wesley-souza8/bruxo-citizentech/cad/totem_bruxo_makerlab-view.dxf

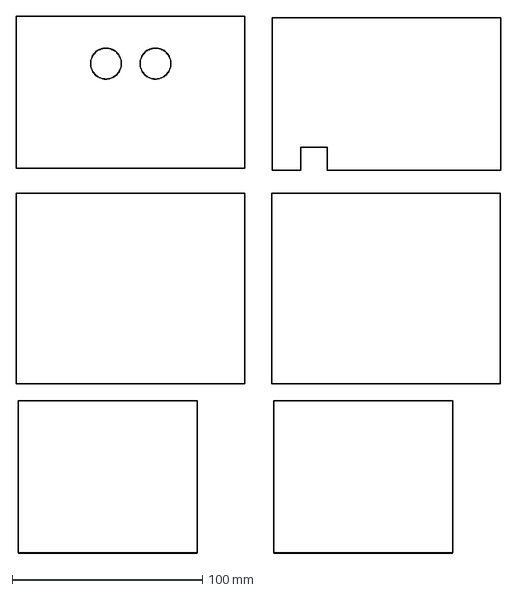
[picture p9: CAD file, 2026-11-10]
cad/totem_bruxo_makerlab-view.dxf
254.2 x 282.0 mm
