wesley-souza8/bruxo-citizentech/src/servicos.py

import os
import re
import time
import urllib.parse
import urllib.request
import webbrowser

import pyautogui
import requests

from src.config import OPENWEATHER_API_KEY


class ServicosWeb:
    """
    Classe responsável por integrações web.
    Lida com APIs (Clima, Dólar) e automação de navegação web (Google, YouTube, Spotify, Portal).
    """

    _TIMEOUT_HTTP = 10

    def obter_clima(self, cidade: str) -> str:
        if not OPENWEATHER_API_KEY:
            return "A chave da API de clima não está configurada no sistema."
        cidade_limpa = (cidade or "").strip()
        if not cidade_limpa:
            return "Não entendi o nome da cidade."
        try:
            url = "https://api.openweathermap.org/data/2.5/weather"
            params = {
                "q": cidade_limpa,
                "appid": OPENWEATHER_API_KEY,
                "units": "metric",
                "lang": "pt_br",
            }
            res = requests.get(url, params=params, timeout=self._TIMEOUT_HTTP).json()
            if res.get("cod") != 200:
                return "Não consegui encontrar os dados de temperatura para essa cidade."
            temp = round(res["main"]["temp"])
            desc = res["weather"][0]["description"]
            return f"A temperatura atual em {cidade_limpa} é de {temp} graus, com {desc}."
        except Exception as e:
            print(f"[ERRO CLIMA]: Falha na consulta ({type(e).__name__}).")
            return "Houve um erro ao consultar o servidor de clima."

    def obter_cotacao_dolar(self) -> str:
        try:
            url = "https://economia.awesomeapi.com.br/json/last/USD-BRL"
            res = requests.get(url, timeout=self._TIMEOUT_HTTP).json()
            valor = float(res["USDBRL"]["bid"])
            valor_fmt = f"{valor:.2f}".replace(".", ",")
            return f"A cotação atual do dólar é de {valor_fmt} reais."
        except Exception as e:
            print(f"[ERRO COTAÇÃO]: Falha na consulta ({type(e).__name__}).")
            return "Não consegui acessar a cotação do dólar no momento."

    def tocar_youtube(self, video: str) -> str:
        try:
            query = urllib.parse.quote(video, safe="")
            url = f"https://www.youtube.com/results?search_query={query}"
            with urllib.request.urlopen(url, timeout=self._TIMEOUT_HTTP) as resp:
                html = resp.read().decode("utf-8", errors="ignore")
            video_ids = re.findall(r"watch\?v=([A-Za-z0-9_-]{11})", html)
            if video_ids:
                webbrowser.open(f"https://www.youtube.com/watch?v={video_ids[0]}")
                return f"Pesquisando e abrindo o vídeo: {video}"
            return "Não encontrei nenhum vídeo com esse nome."
        except Exception as e:
            print(f"[ERRO YOUTUBE]: Falha ao buscar vídeo ({type(e).__name__}).")
            return "Ocorreu um erro ao tentar abrir o vídeo."

    def tocar_spotify(self, artista: str) -> str:
        try:
            query = urllib.parse.quote(artista, safe="")
            uri_spotify = f"spotify:search:{query}"
            if hasattr(os, "startfile"):
                os.startfile(uri_spotify)
            else:
                webbrowser.open(uri_spotify)

            # Aguarda o Spotify abrir e renderizar a busca
            time.sleep(5)

            pyautogui.FAILSAFE = False
            # Pressiona tab algumas vezes para sair da barra de busca e focar no 'Melhor Resultado'
            pyautogui.press('tab', presses=3, interval=0.3)
            time.sleep(0.5)
            pyautogui.press('enter')
            time.sleep(1)
            pyautogui.press('enter')  # Confirma o play no cartão selecionado

            return f"Abrindo o Spotify para tocar {artista}."
        except Exception as e:
            print(f"[ERRO SPOTIFY]: Falha ao controlar o Spotify ({type(e).__name__}).")
            return "Houve um erro ao tentar controlar o Spotify."

    def pesquisar_google(self, termo: str, ia) -> str:
        if hasattr(ia, "avaliar_seguranca_termo"):
            permitido = ia.avaliar_seguranca_termo(termo)
        else:
            permitido = False
        if not permitido:
            return "Desculpe, não posso pesquisar isso. O termo viola as políticas de segurança."
        webbrowser.open(f"https://www.google.com/search?q={urllib.parse.quote(termo, safe='')}")
        return "Tudo certo, abrindo o Google."

    def abrir_portal_fiap(self):
        webbrowser.open("https://on.fiap.com.br/")


class ControleSistema:
    """
    Classe responsável por automação do sistema operacional (hardware/mídia).
    """
    def aumentar_volume(self):
        pyautogui.press('volumeup', presses=5)

    def diminuir_volume(self):
        pyautogui.press('volumedown', presses=5)

    def mutar_desmutar(self):
        pyautogui.press('volumemute')

    def pausar_despausar(self):
        pyautogui.press('playpause')
