wesley-souza8/bruxo-citizentech/(commit log)

2026-11-10 feat: integra Totem Cidadao Bruxo com Arduino HC-SR04, CAD MDF e documentacao
    [totem_bruxo_makerlab-view.dxf]
2026-11-10 fix: aprimora firmware anti-repique, fallback Groq/TTS, filtro eco e guia Arduino IDE
    [assistente.py, config.py, easter_eggs.py, main.py, reconhecimento.py, servicos.py, totem_sensor.ino]
2026-11-11 test: torna teste de path traversal portável para macOS/Linux
    O teste usava "C:\temp\rostos" como pasta de rostos, que só é absoluta no
    Windows. No macOS/Linux o caminho vira relativo e os.path.commonpath lança
    ValueError ao misturá-lo com o caminho absoluto calculado. Agora usa
    tempfile.gettempdir(), absoluto em qualquer SO, como o __init__ real de
    GerenciadorFacial.
2026-11-11 feat: Bruxo se despede por voz quando o cidadão se afasta
    - Novo callback despedir_afastamento (Estado 4): ao confirmar o afastamento
    pelo HC-SR04, encerra a sessão, volta ao Standby e fala DESPEDIDA_TOTEM
    ("Tchau, até logo! Foi um prazer atender você.").
    - A despedida espera a fala ou o comando em andamento terminar (não corta a
    saudação, respostas da IA ou a leitura OCR) e só vale para quem foi
    saudado: não se repete após "tchau" e é cancelada se outro cidadão for
    saudado.
    - SensorArduino ganha confirmacao_afastamento_segundos: o afastamento só é
    confirmado após leituras distantes contínuas, para que um eco falso
    isolado não encerre o atendimento (CONFIRMACAO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
2026-11-11 fix: descarta áudio captado enquanto o Bruxo fala (eco da saudação)
    Quando o HC-SR04 dispara a saudação com o microfone já escutando, o
    microfone captava a própria voz do Bruxo. Erros de transcrição (ex.:
    "bem-vindo ao autor tem cidadão") escapavam do filtro por texto, o trecho
    virava pergunta, a saudação era cortada por voz.parar() e a IA respondia
    ao eco.
    - SintetizadorVoz registra os intervalos de reprodução e expõe
    tempo_falando_entre(inicio, fim).
    - OuvinteMicrofone registra em ultima_captura a janela de tempo do áudio
    captado.
    - O loop principal descarta ([ECO IGNORADO]) o trecho que coincidir por
    mais de 0,3 s com a fala do Bruxo; o filtro por texto segue como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
    [assistente.py, microfone.py, voz.py]
2026-11-11 chore: prepara repositorio para entrega (remove roteiro e ajusta docs/codigo)
